BarabashkaD/radio-86rk-rom/KiCad/exports/radio-86rk-rom-3d.png

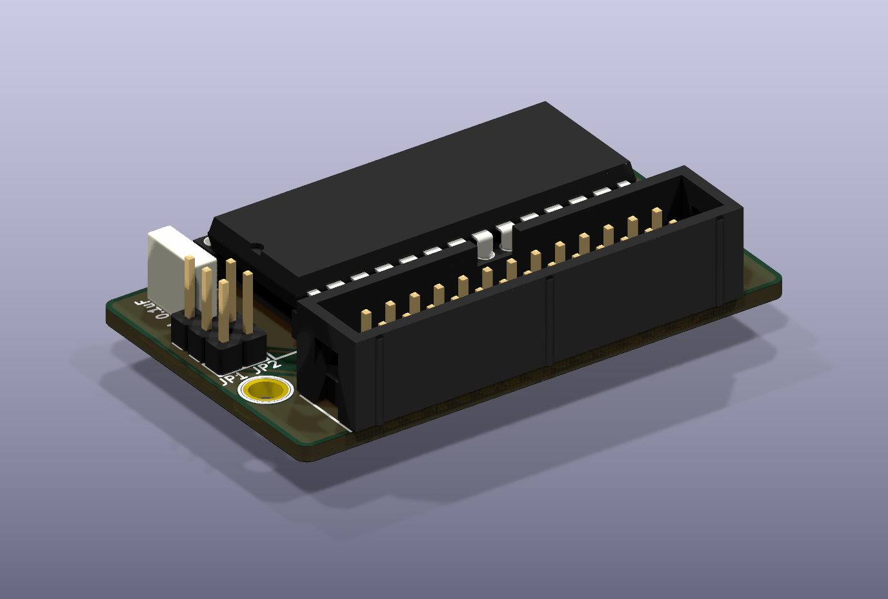
KiCad/exports/radio-86rk-rom-3d.png
