BarabashkaD/radio-86rk-rom/KiCad/exports/radio-86rk-rom.step

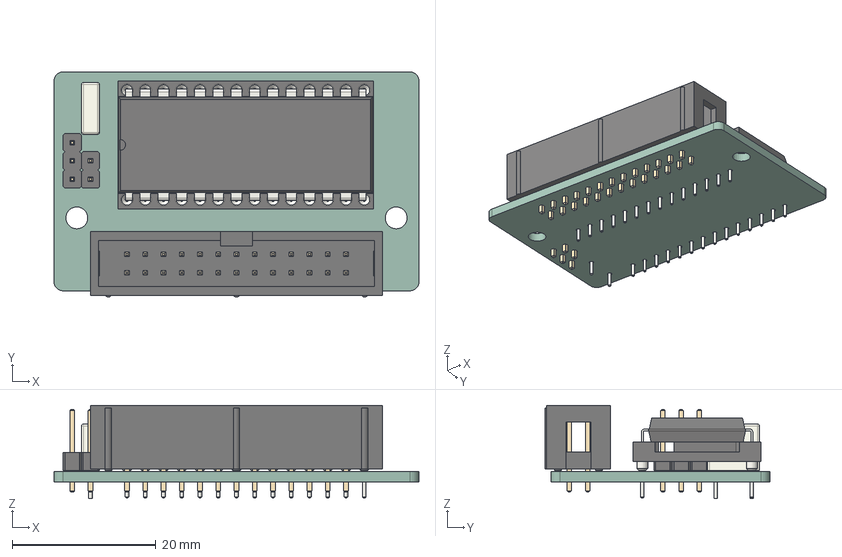
[picture p2: CAD file, 2026-10-20]
KiCad/exports/radio-86rk-rom.step
50.8 x 31.3 x 13.0 mm
PinHeader_1x03_P254mm_Vertical
DIP_28_W1524mm_Socket
DIP-28_W15.24mm
IDC_Header_2x13_P254mm_Vertical
C_Rect_L7.2mm_W2.5mm_P5.00mm
PinHeader_1x02_P254mm_Vertical
radio-86rk-rom_PCB
