BarabashkaD/radio-86rk-rom/(list of files, cad)

Other CAD files:
KiCad/exports/radio-86rk-rom.FCStd
