BarabashkaD/radio-86rk-rom/KiCad/radio-86rk-rom.kicad_pcb

## KiCad design KiCad/radio-86rk-rom.kicad_pcb (2026-10-20)

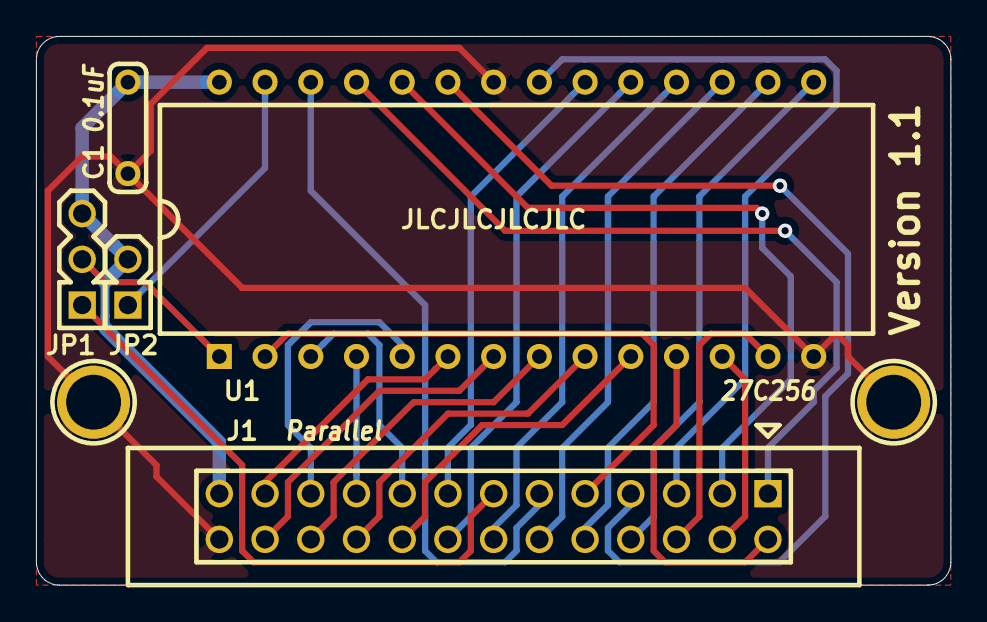
[picture p3: board radio-86rk-rom.kicad_pcb from above]

Board: 2 copper layers, 50.8 x 30.5 mm, 7 parts (0 on the bottom side), 28 nets.

Parts:
C1: 0.1uF; Cap_Cer_508
HOLE1, HOLE2: HOLE; Hole_3mm
J1: Parallel; Conn_Pin_Header_13x2_2.54mm_Shrouded
JP1: ROM_1; Conn_Pin_Header_3x1_2.54mm
JP2: ROM_27; Conn_Pin_Header_2x1_2.54mm
U1: 27C256; IC_DIP28_600

Connections:
/PA0: J1.2, U1.11
/PA1: J1.4, U1.12
/PA2: J1.6, U1.13
/PA3: J1.8, U1.15
/PA4: J1.10, U1.16
/PA5: J1.12, U1.17
/PA6: J1.14, U1.18
/PA7: J1.16, U1.19
/PB0: J1.18, U1.10
/PB1: J1.20, U1.9
/PB2: J1.22, U1.8
/PB3: J1.24, U1.7
/PB4: J1.23, U1.6
/PB5: J1.21, U1.5
/PB6: J1.19, U1.4
/PB7: J1.17, U1.3
/PC0: J1.1, U1.25
/PC1: J1.3, U1.24
/PC2: J1.5, U1.21
/PC3: J1.7, U1.23
/PC4: J1.9, U1.2
/PC5: J1.11, U1.26
/PC6: J1.13, JP1.1
/PC7: J1.15, U1.20
GND: C1.2, HOLE1.1, HOLE2.1, J1.26, U1.14, U1.22
unnamed: JP1.2, U1.1
unnamed: JP2.1, U1.27
VCC: C1.1, J1.25, JP1.3, JP2.2, U1.28
