BarabashkaD/radio-86rk-rom/(commit log)

2026-10-20 Modernize KiCad project and bundle portable CAD dependencies
    Migrate to KiCad 10.0.7 with local symbol, footprint and 3D model libraries. Add populated STEP and FreeCAD exports, validation evidence, and documented remaining ERC/DRC findings while preserving original connectivity and routing.
2026-10-20 Add DIP-28 socket beneath U1 in 3D assembly
    Bundle the socket model, seat the chip at the socket height, and refresh STEP, FreeCAD and preview exports. Record seven valid imported solids while preserving all non-model PCB content.
