BarabashkaD/radio-86rk-rom/(notices)

Notices in the files:
KiCad/radio-86rk-rom.kicad_pcb:
Copyright (C) 2020 Sergey Kiselev
GPL
